MoKasaei/SMPS-18V-EE16/SMPS-18V-EE16-sch.pdf

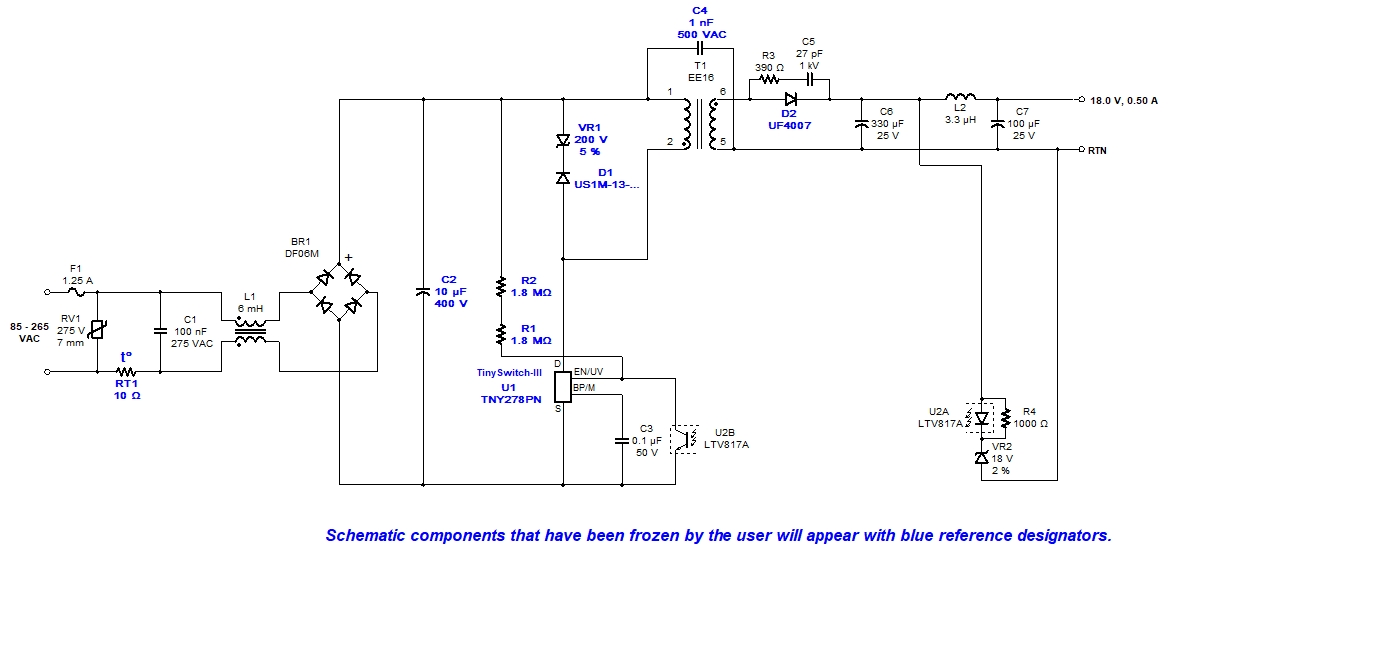
[picture p3: page 1]
