MoKasaei/SMPS-18V-EE16/SMPS_18V/SMPS_18V-schematic.pdf

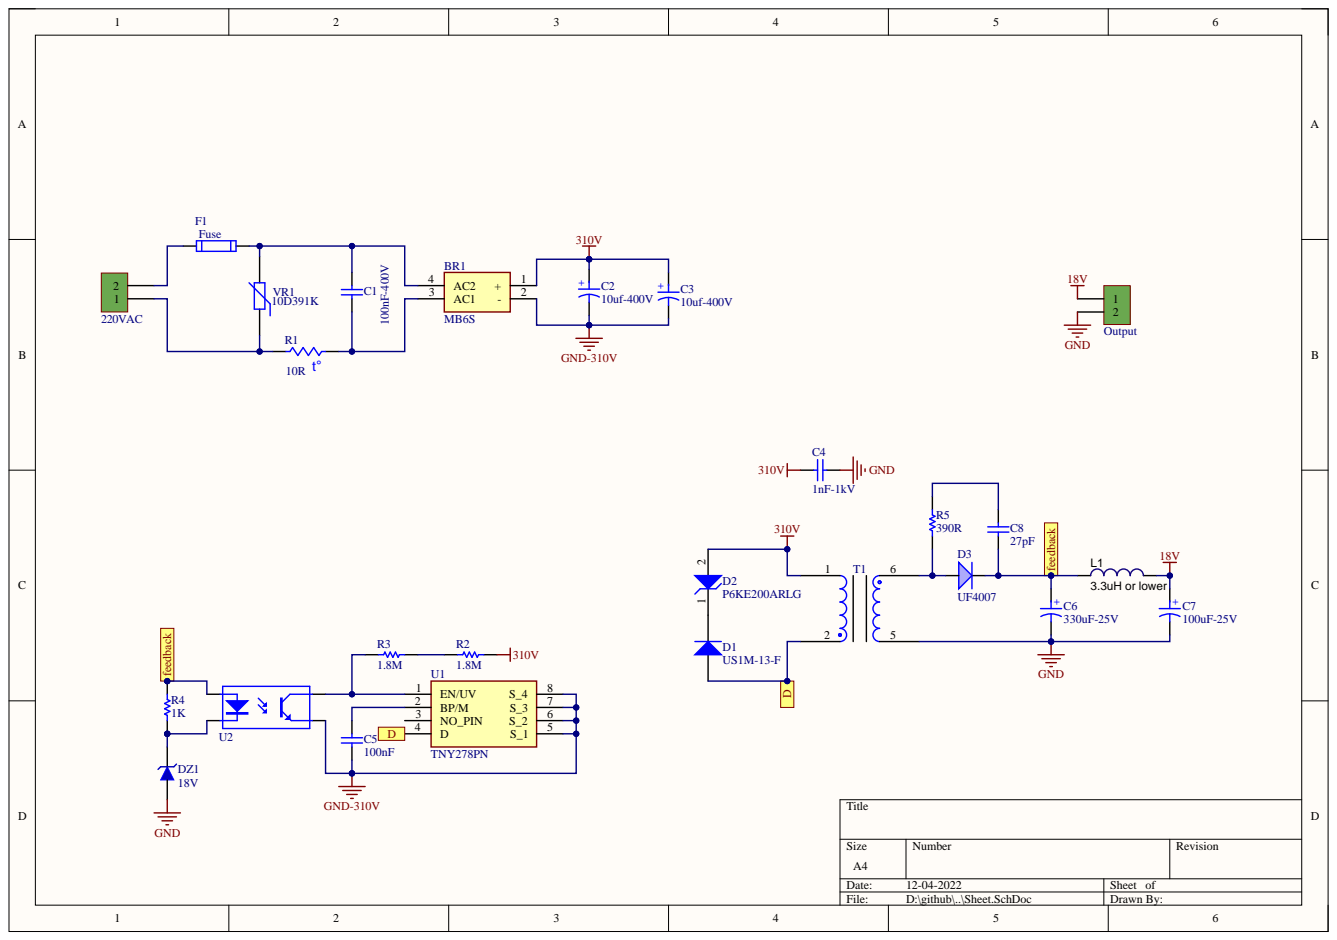
[picture p4: page 1]

Size A4 | Number | Revision

Date: 12-04-2022 | Sheet of
File: D:\github\..\Sheet.SchDoc | Drawn By:
