MoKasaei/SMPS-18V-EE16/(list of files, drawings)

Other design files:
SMPS_18V/EE16-18V.PcbLib
SMPS_18V/EE16-18V.SchLib
SMPS_18V/Sheet.SchDoc
SMPS_18V/SMPS_18V.PrjPcb
