MoKasaei/SMPS-18V-EE16/(commit log)

2022-12-04 Designing schematic and PCB
    EE16 Footprint and PI Expert design is included
    [EE16-18V.PcbLib, EE16-18V.SchLib, SMPS_18V.PrjPcb, Sheet.SchDoc]
2022-12-04 Final V1
    [EE16-18V.PcbLib, EE16-18V.SchLib, SMPS_18V.PrjPcb, Sheet.SchDoc]
